rswift/wifi-temperature-broadcast/Resources/Fritzing Hall Effect - Breadboard View.png

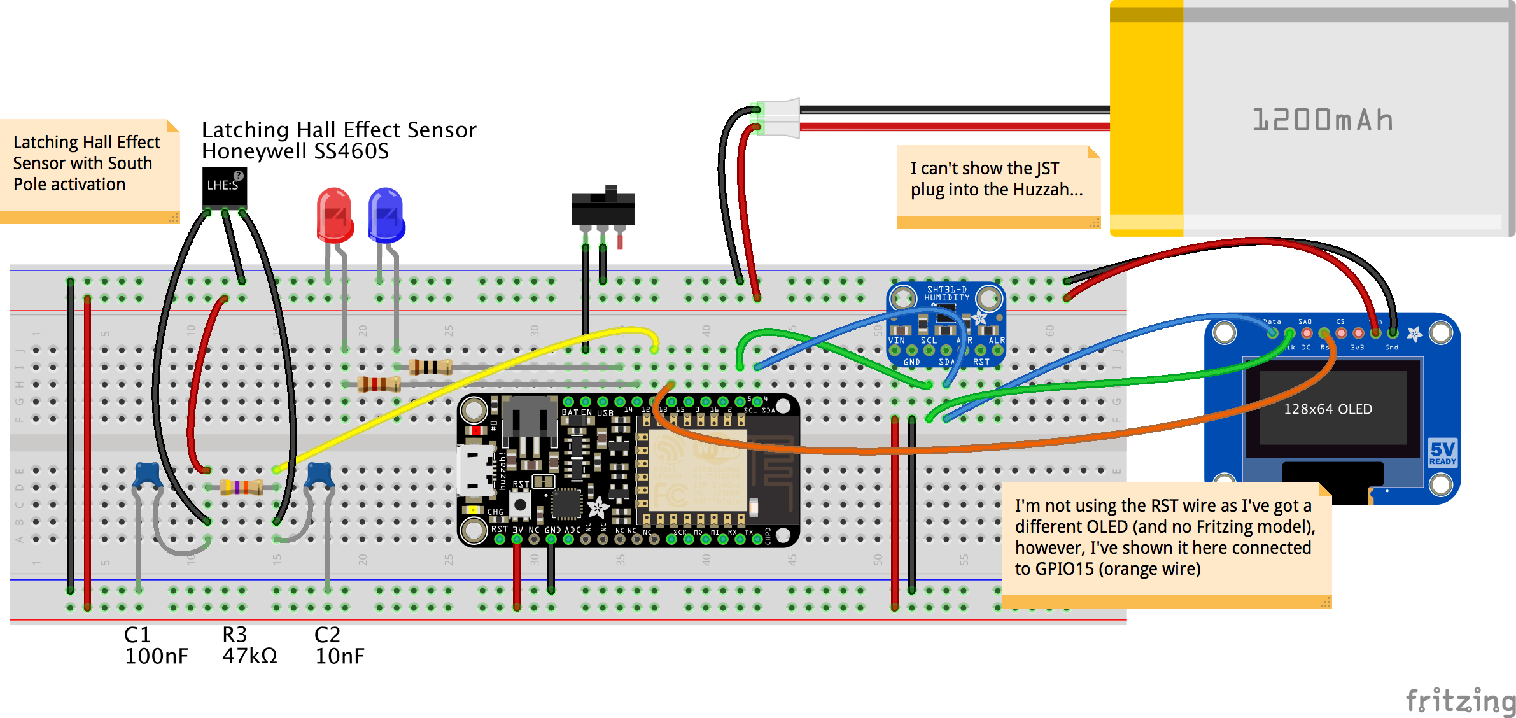
Resources/Fritzing Hall Effect - Breadboard View.png
