rswift/wifi-temperature-broadcast/Resources/Fritzing Thermocouple - Breadboard View.png

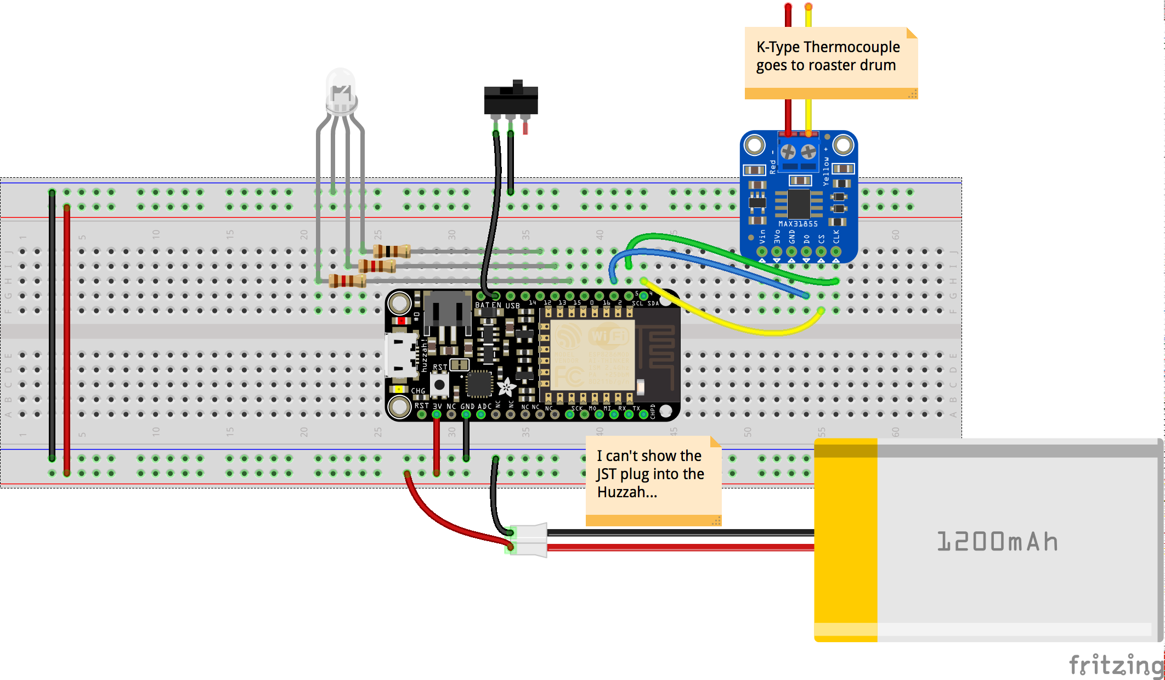
Resources/Fritzing Thermocouple - Breadboard View.png
