rswift/wifi-temperature-broadcast/(threads)

Thread 5 (2019-04-18):

Sudden incorrect bean mass temperatures

rswift, 2019-04-18:
I noticed recently the bean mass temperatures shot up. No changes to anything at all. I guessed that the thermocouple had probably given up...

So I replaced it, and... no difference!? hmm...

Turned out the hall effect sensor had become magnetised the opposite way, unclear how. But a few passes with a magnet manually to confirm it *could* behave correctly, then ensuring it was properly aligned to my north/south magnets (see [photo](https://github.com/rswift/wifi-temperature-broadcast/blob/master/README.md#the-setup)) and it started working fine again. Obviously this is all specific to my setup, but the principle could affect any arrangement I suppose?

Closed 2019-04-18.
