rswift/wifi-temperature-broadcast/(commit log)

2016-05-11 First commit of a trivial chunk of code to broadcast the temperature from an Adafruit MAX31855 over WiFi
2016-07-13 Added tilt-switch code
2016-09-11 hardware
    Breadboard view from Fritzing of the hardware configuration for my
    magnet based drum trigger for the Gene Cafe coffee roaster.
2016-09-11 HallEffectBroadcast.ino
    Arduino code to run on the ESP8266 to handle the Hall Effect latch
    sensor, plus also a Temperature & Humidity sensor…
2016-09-11 Added Hall Effect code, cleaned up WiFi broadcast code, added licence
    Created Arduino IDE friendly directories for each of the two projects
    (WiFi Broadcast and Hall Effect Broadcast).
    Added Hall Effect project.
    Added Hall Effect UDP listener, and cleaned up WiFi broadcast source
    file.
    Added MIT licence and clarified BSD licence text in WiFi broadcast.
2016-09-11 Update README.md
    Added details of Hall Effect Sensor
2016-09-12 Split into multiple .ino files
    Separated code into several .ino files for readability but also to make
    it easier manage…
2016-09-12 Revised Fritzing and updated Hall Effect .ino
    Removed unused resistors from Fritzing view
    Extracted the LED flash function into a utilities source file.
2016-09-12 Thermocouple Hardware
    Fritzing diagram of the thermocouple amplifier, ESP8266 and basic
    status LED.
2016-09-12 Fixed daft logic bug preventing any data being broadcast!
    [MessageFormatters.ino, TemperatureLinearisation.ino, Utilities.ino, WiFiTemperatureBroadcast.ino, fnBroadcastReadings.ino, fnCheckCommandAndControl.ino, fnReadProbes.ino]
2016-09-13 Bug fixes
    Incorrect Error LED if no RDP Server available
    Turned off logging by default
    [HallEffectBroadcast.ino, WiFiTemperatureBroadcast.ino, fnBroadcastReadings.ino]
2016-09-20 Increased array size
    Increased capacity of average temperature array
2016-09-20 Performance improvement
    Increased performance of probe reading by not flashing the LED which
    simply wasted approximately quarter of a second’s worth of probe
    reading time…
2016-09-20 Added OLED
    Added an I2C 128x64 OLED with rows 0-15 yellow, 16-63 blue. Not an
    Adafruit OLED so the RST pin isn’t assigned but I didn’t have a
    suitable Fritzing design so this’ll do just fine…
2016-09-20 Added OLED + status display code
    Code now listens for probe broadcast, sweeps up (via ArduinoJson
    library) bean mass temperature and probe ESP8266 VCC value to display
    alongside ambient temperature & humidity…
2016-10-02 Small tweak for RM v10 RDP
    Minor change to pre-broadcast the temperature before the roast starts,
    which for my roaster is when the drum starts to rotate. Roastmaster
    needs a probe to be active before it’ll start the roast session…
2016-10-09 Added combined sensor reading function
    Added code to call a custom SHT31 library function to return both
    temperature and humidity in one go
    Also disabled LED flashing as this is rather pointless and simply adds
    a delay to loop()
2016-10-09 Optimisations for revised MAX31855 library
    Updated to call a d dual probe reading function instead of making
    separate hot & cold junction readings (as the hardware returns both
    anyway)… Code now performs approximately 17x faster!
